azwadsultan-lab/Fungal-Playback/plots/channel_0.png

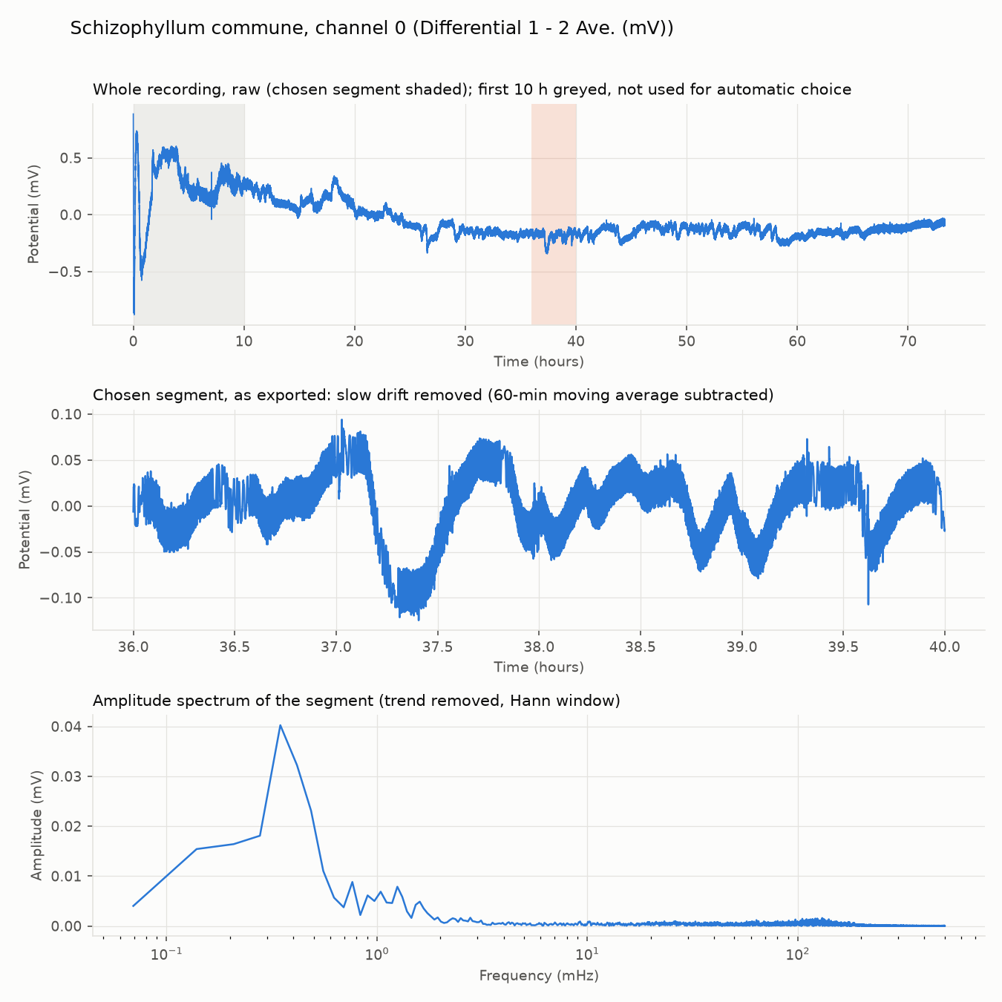
plots/channel_0.png
