azwadsultan-lab/Fungal-Playback/plots/channel_1.png

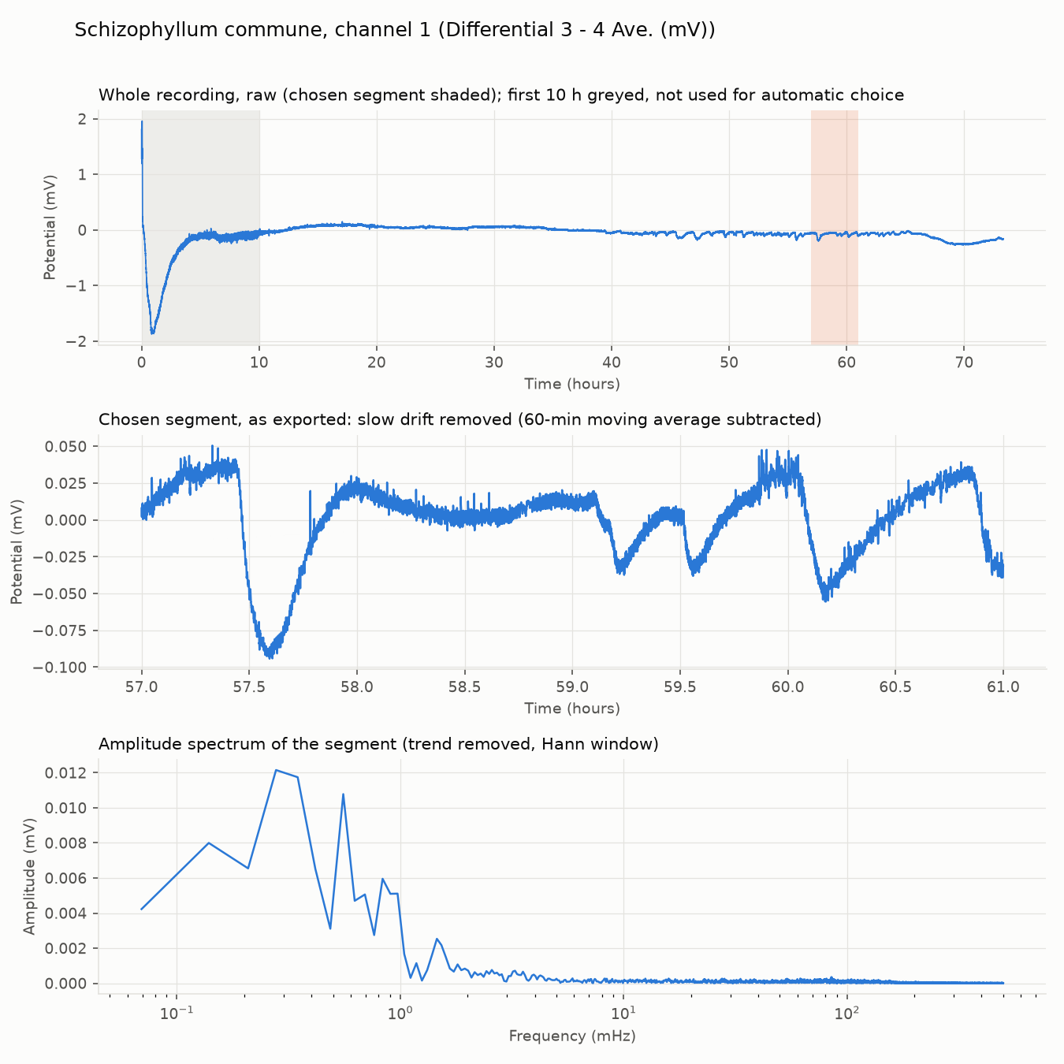
plots/channel_1.png
