azwadsultan-lab/Fungal-Playback/plots/channel_2.png

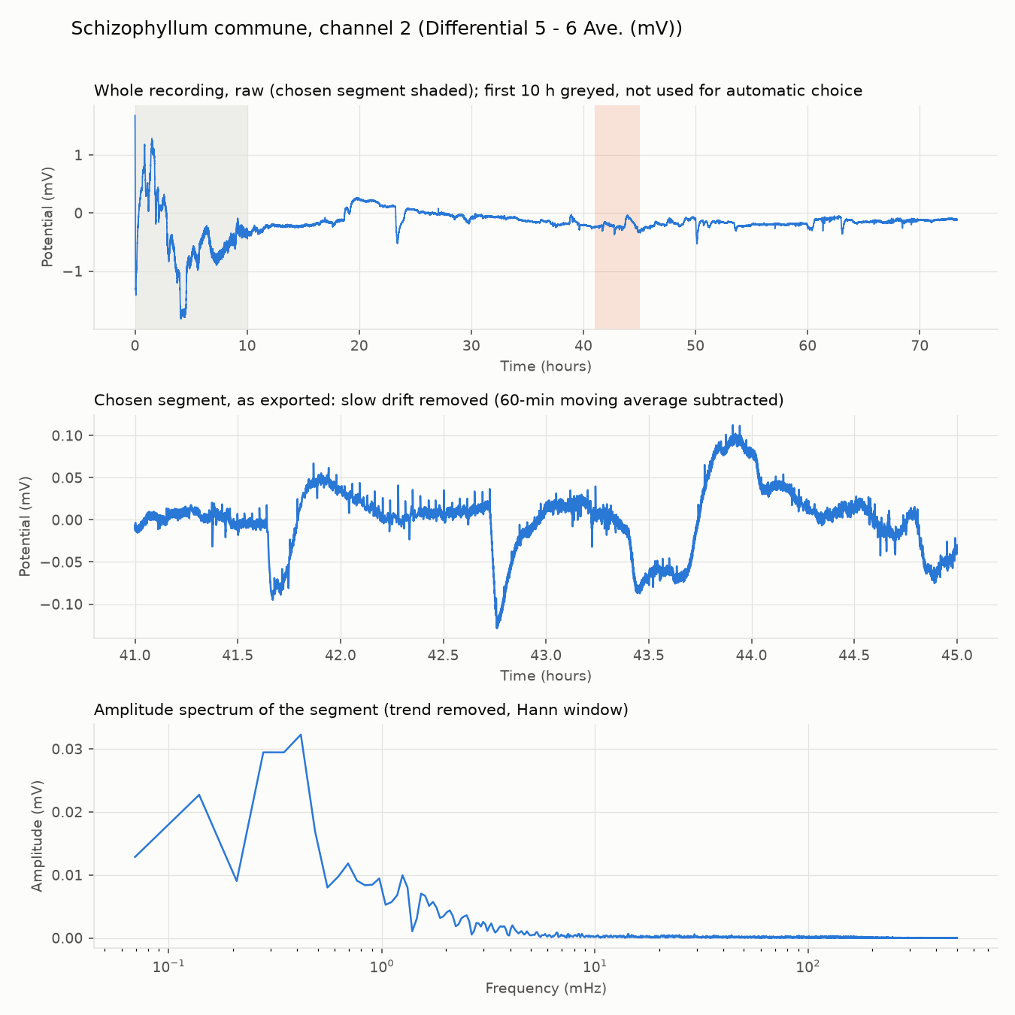
plots/channel_2.png
