azwadsultan-lab/Fungal-Playback/plots/channel_3.png

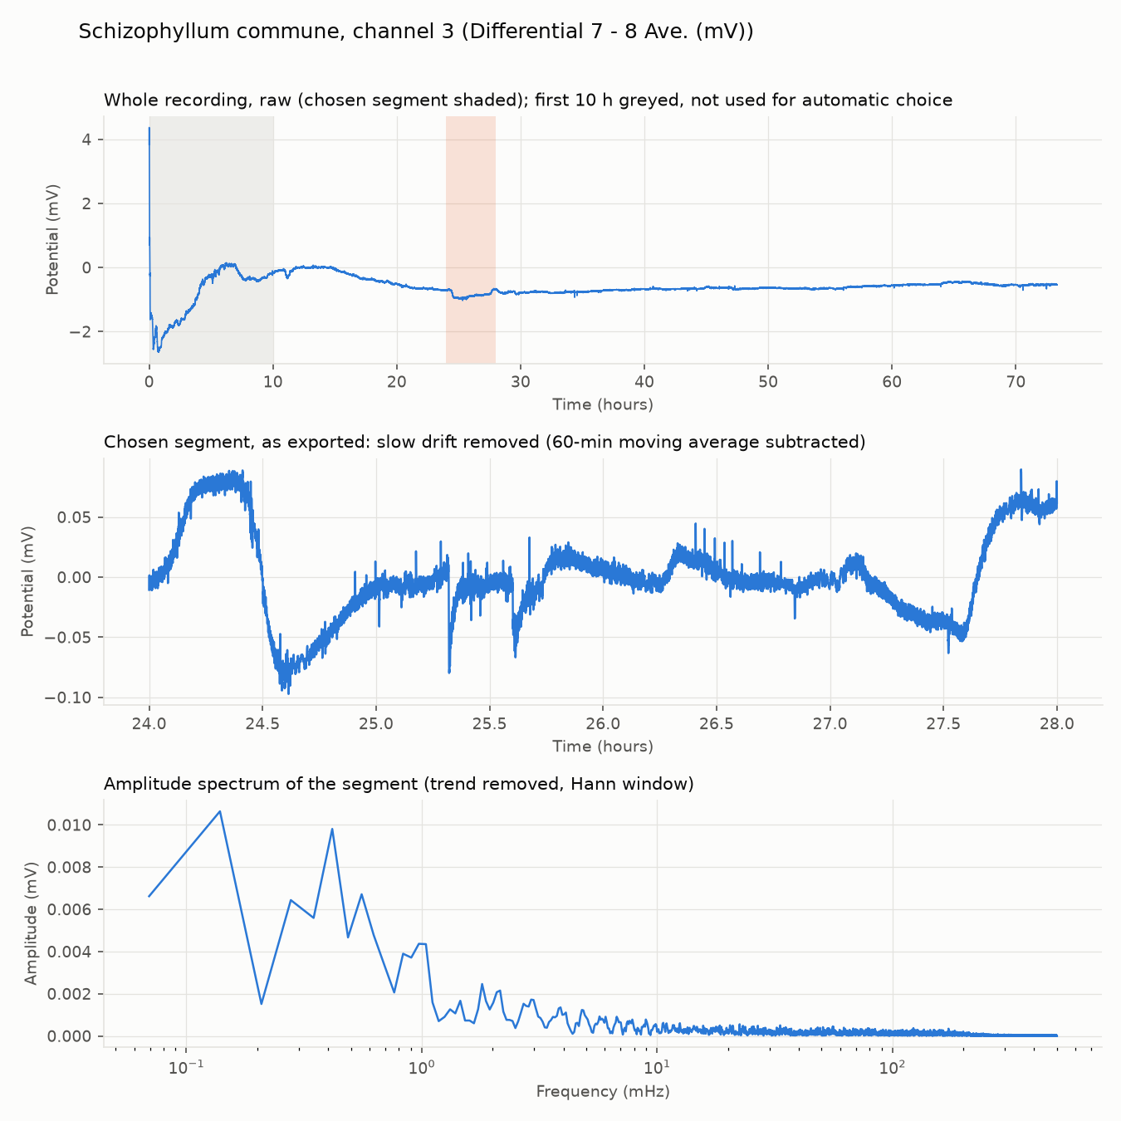
plots/channel_3.png
