azwadsultan-lab/Fungal-Playback/plots/channel_4.png

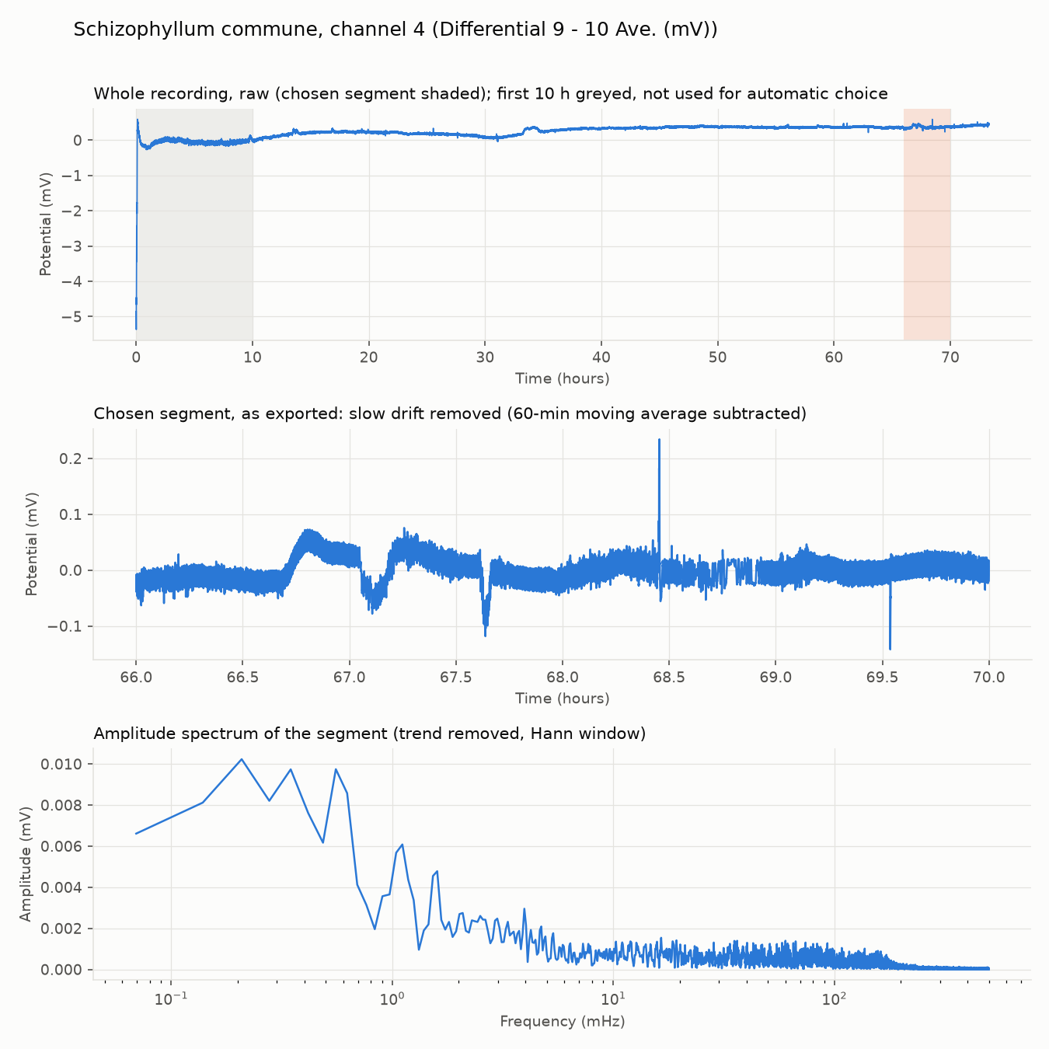
plots/channel_4.png
