azwadsultan-lab/Fungal-Playback/plots/channel_5.png

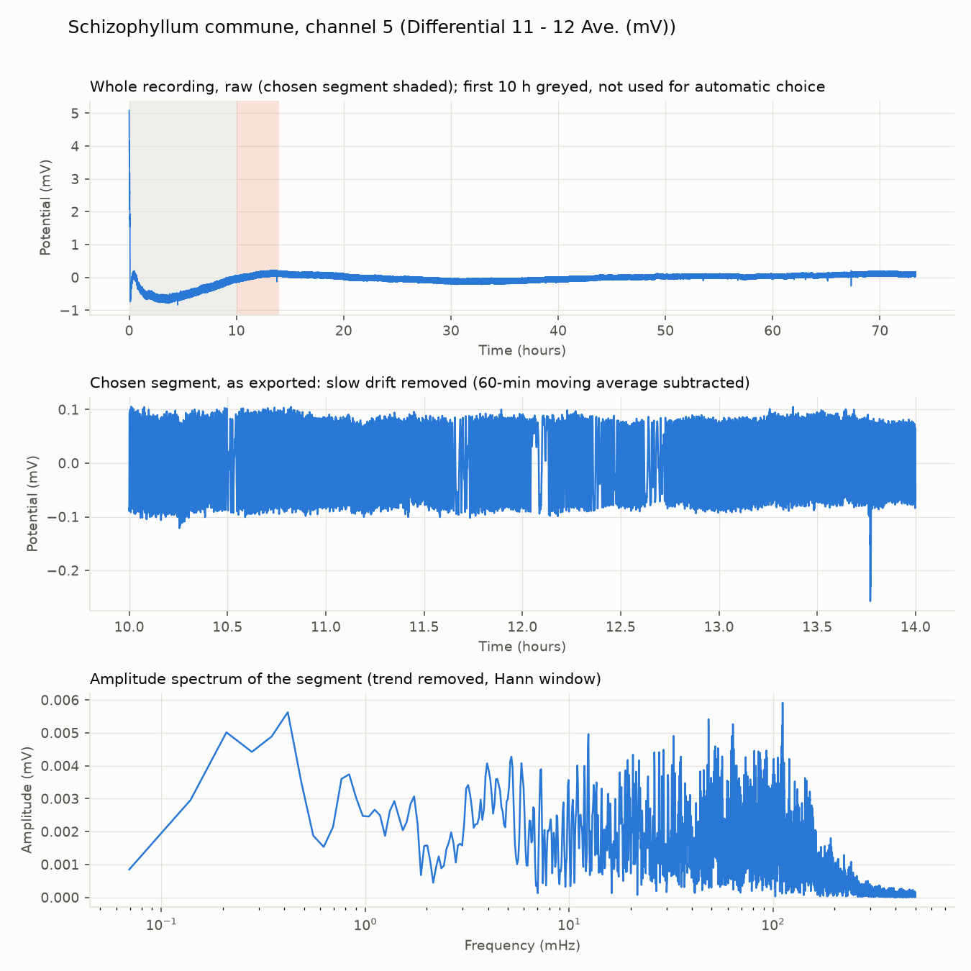
plots/channel_5.png
